tibersam/lightcontroller-schematic/lightcontroll-4.png

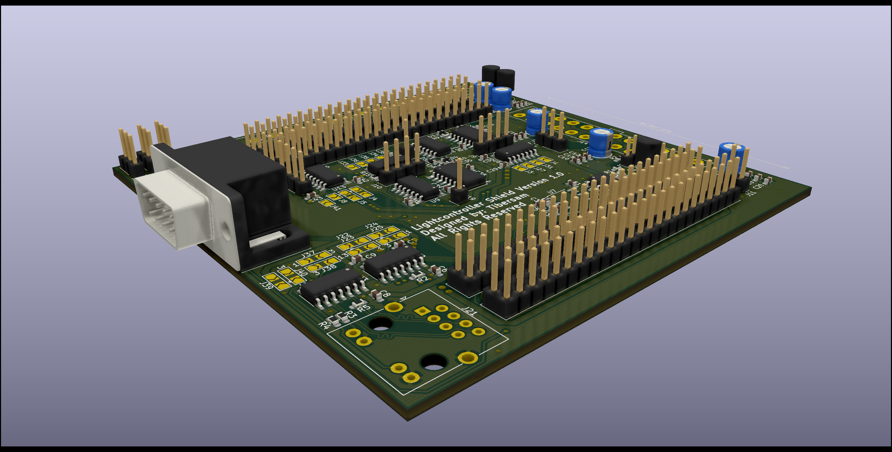
lightcontroll-4.png
