tibersam/lightcontroller-schematic/lightcontroll-6.jpg

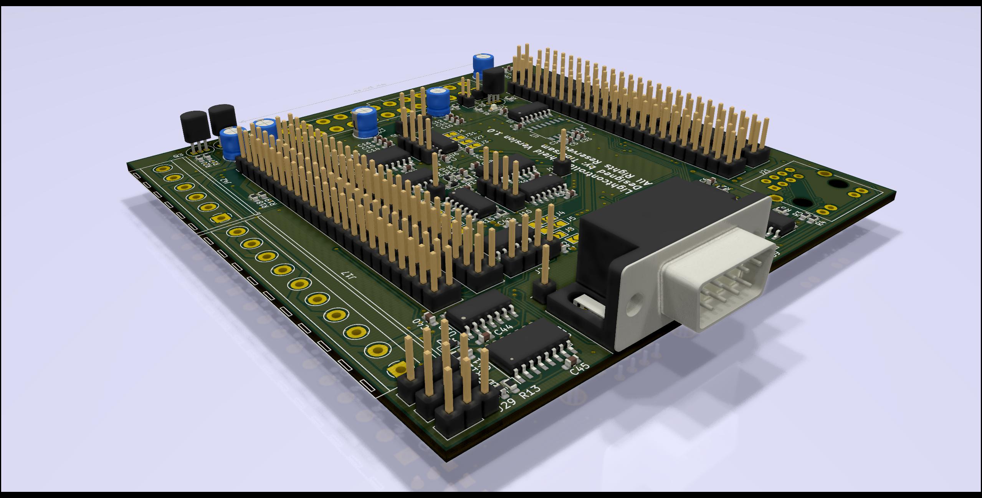
lightcontroll-6.jpg
