tibersam/lightcontroller-schematic/lightcontroll-2.png

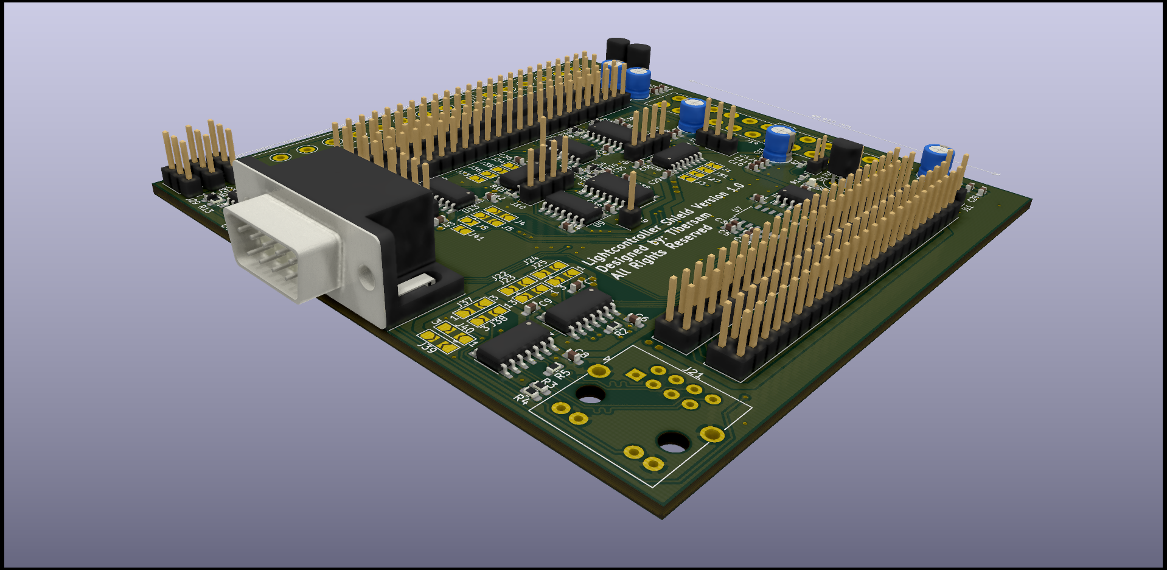
lightcontroll-2.png
