tibersam/lightcontroller-schematic/lightcontroll-3.png

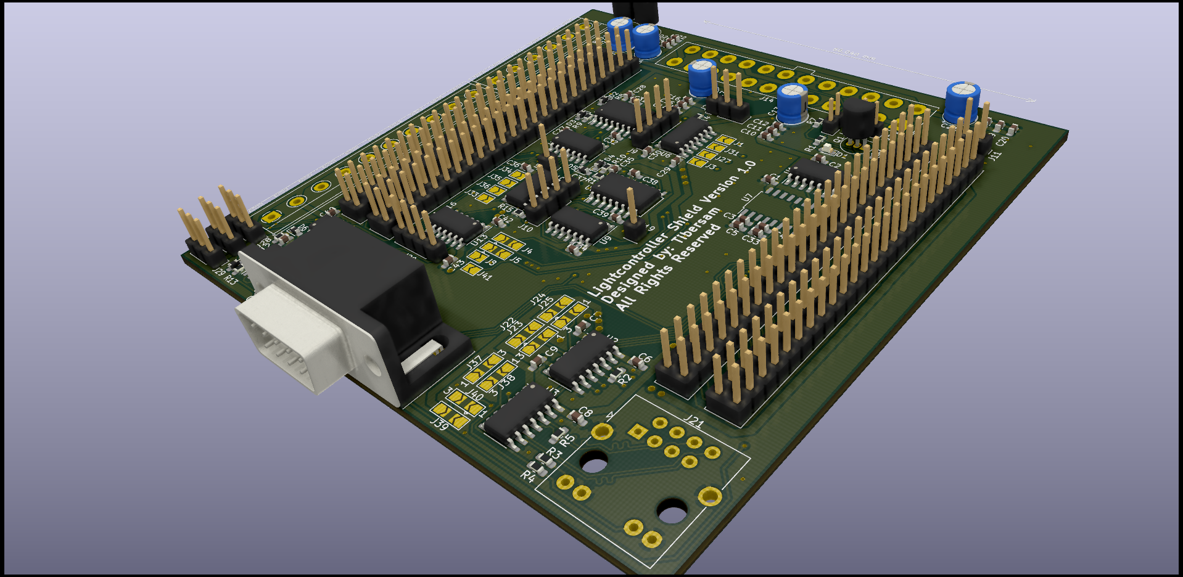
lightcontroll-3.png
