tibersam/lightcontroller-schematic/lightcontroll-5.jpg

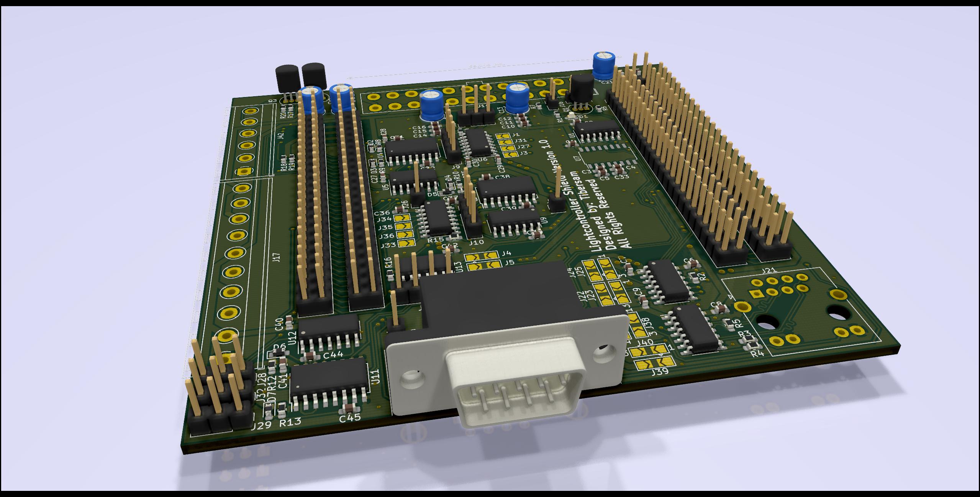
lightcontroll-5.jpg
