tibersam/lightcontroller-schematic/lightcontroll-5.png

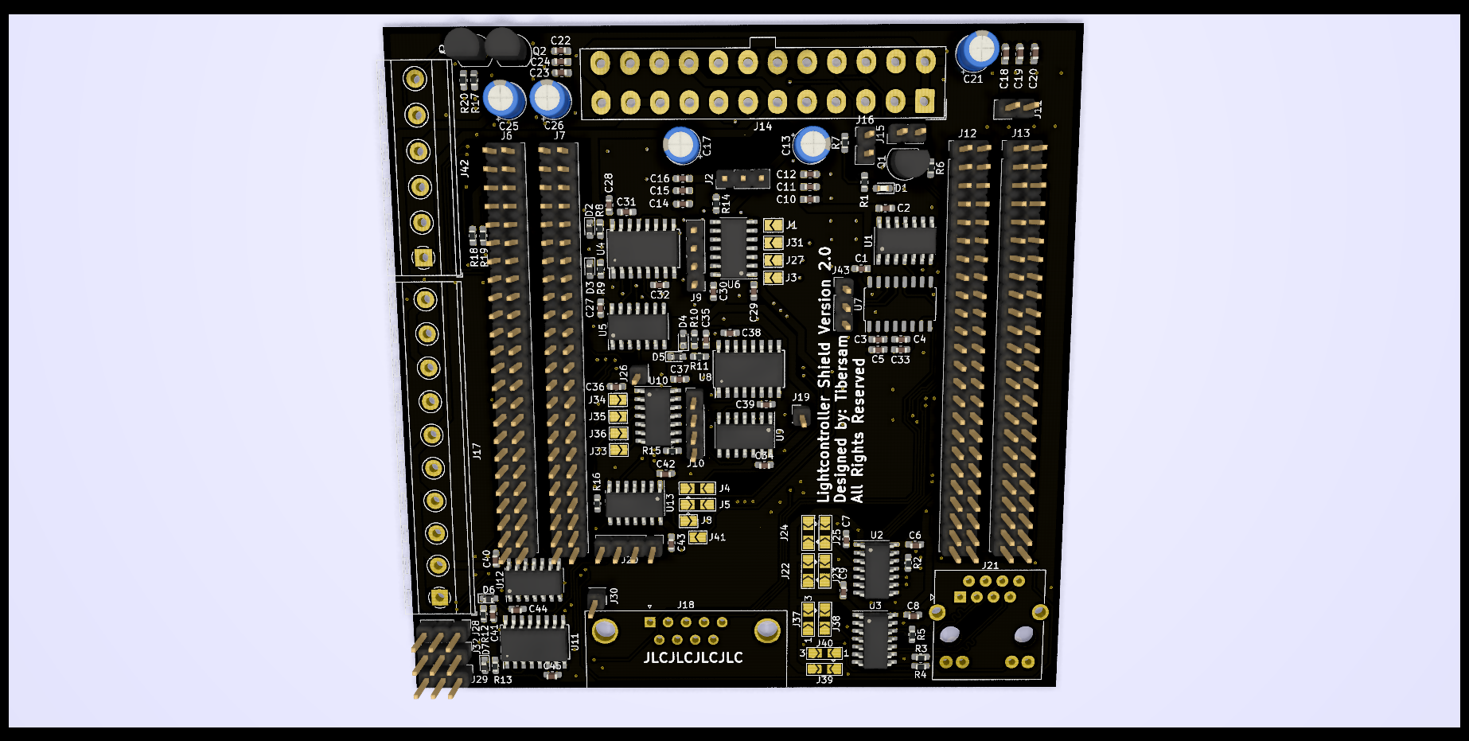
lightcontroll-5.png
