tibersam/lightcontroller-schematic/lightcontroll.png

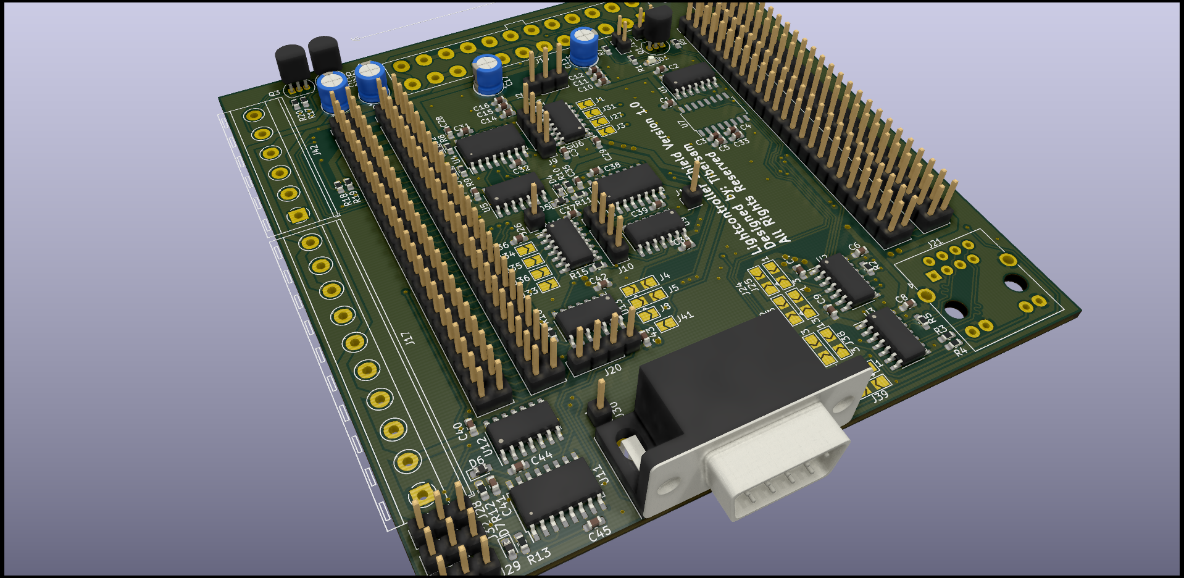
lightcontroll.png
