tibersam/lightcontroller-schematic/schematic/lightcontroll/lightcontroll.kicad_pcb

## KiCad design schematic/lightcontroll/lightcontroll.kicad_pcb (2022-01-22)

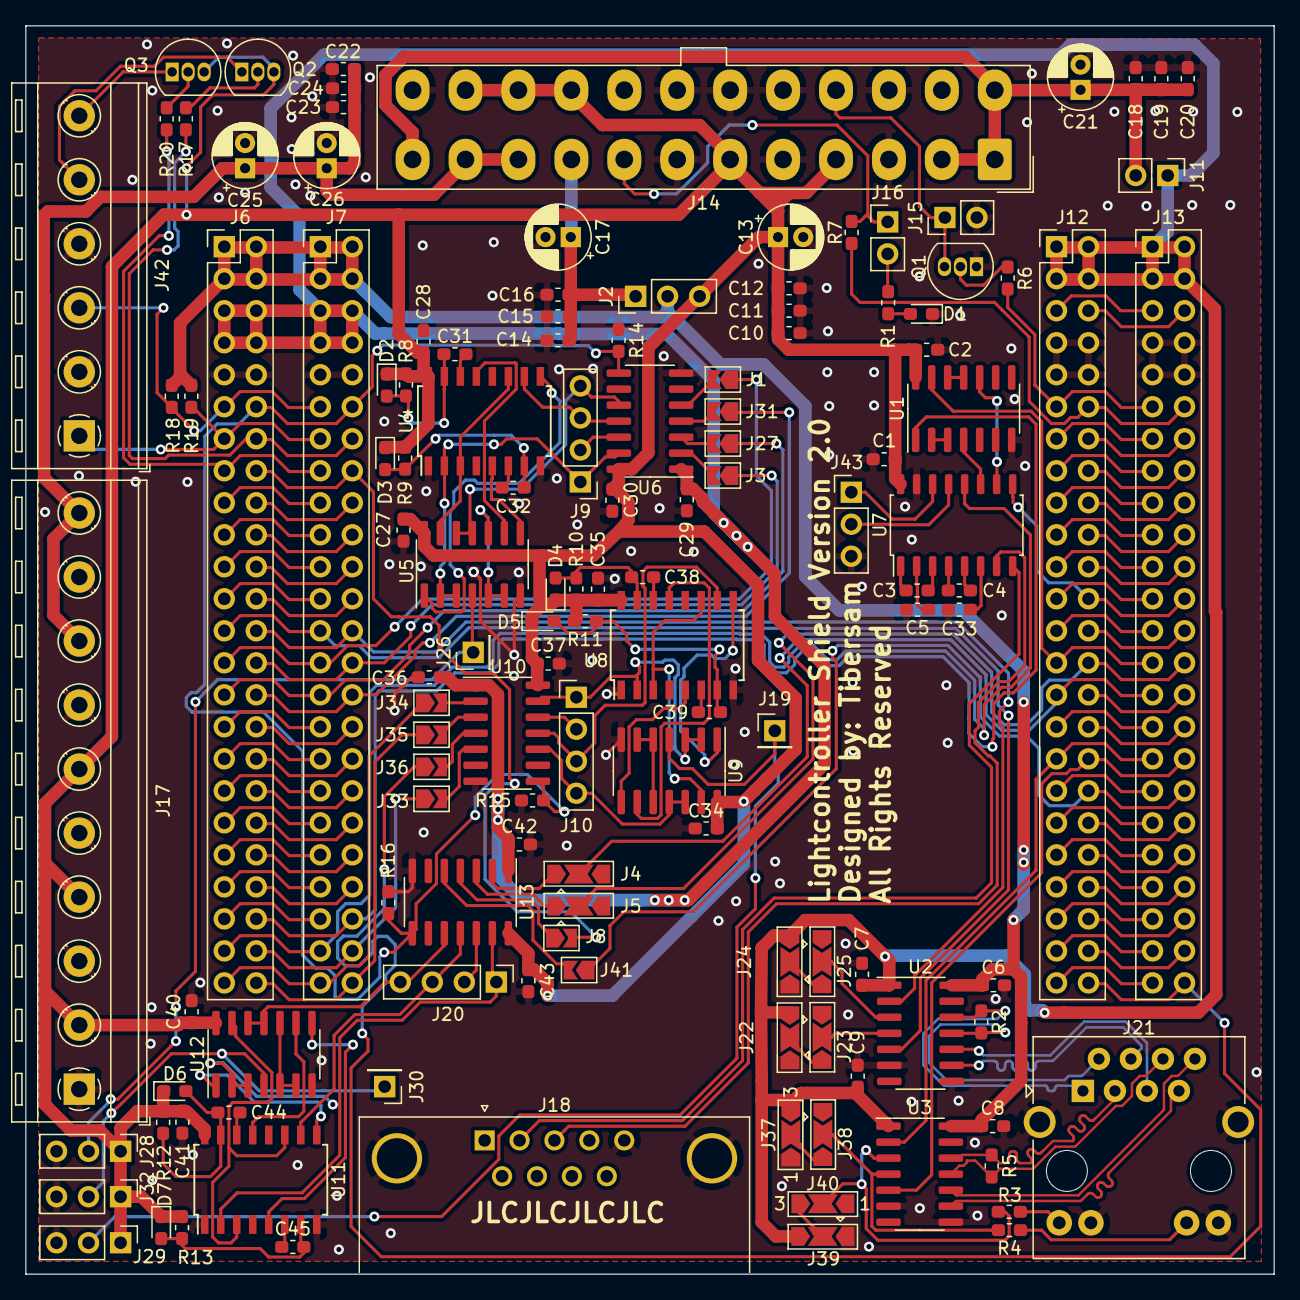
[picture p8: board lightcontroll.kicad_pcb from above]

Board: 2 copper layers, 99.1 x 99.1 mm, 131 parts (0 on the bottom side), 180 nets.

Parts:
C1, C3, C4, C5, C6, C8, C11, C15, C19, C23, C33: 1uF; C_0603_1608Metric_Pad1.05x0.95mm_HandSolder
C2, C7, C9, C10, C14, C18, C22, C27, C28, C29, C30, C34, C35, C36, C37, C40, C41, C42, C43: 100nF; C_0603_1608Metric_Pad1.05x0.95mm_HandSolder
C12, C16, C20, C24: 10uF; C_0603_1608Metric_Pad1.05x0.95mm_HandSolder
C13, C17, C21, C25, C26: 100uF; CP_Radial_D5.0mm_P2.00mm
C31, C32, C38, C39, C44, C45: 200pF; C_0603_1608Metric_Pad1.05x0.95mm_HandSolder
D1: LED; LED_0603_1608Metric_Pad1.05x0.95mm_HandSolder
D2, D3, D4, D5, D6, D7: D_Schottky; D_0603_1608Metric_Pad1.05x0.95mm_HandSolder
J1: SPI1_SS; SolderJumper-2_P1.3mm_Open_TrianglePad1.0x1.5mm
J2: 5V Selector; PinHeader_1x03_P2.54mm_Vertical
J3: SPI1_CLK; SolderJumper-2_P1.3mm_Open_TrianglePad1.0x1.5mm
J4, J5: UART/SPI JUMPER; SolderJumper-3_P2.0mm_Open_TrianglePad1.0x1.5mm
J6, J7: Conn_02x24_Odd_Even; PinHeader_2x24_P2.54mm_Vertical
J8: UART/SPI JUMPER; SolderJumper-2_P1.3mm_Open_TrianglePad1.0x1.5mm
J9, J10, J20: SPI 5V; PinHeader_1x04_P2.54mm_Vertical
J11: 3.3V jumper; PinHeader_1x02_P2.54mm_Vertical
J12, J13: Header 24X2; PinHeader_2x24_P2.54mm_Vertical
J14: ATX24connector; Molex_Mini-Fit_Jr_5566-24A_2x12_P4.20mm_Vertical
J15, J16: PWR_JMP; PinHeader_1x02_P2.54mm_Vertical
J17: Power Connector; TerminalBlock_RND_205-00295_1x10_P5.08mm_Horizontal
J18: DB9_Female_MountingHoles; DSUB-9_Male_Horizontal_P2.77x2.84mm_EdgePinOffset7.70mm_Hou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
J19, J26, J30: SK2812_sig; PinHeader_1x01_P2.54mm_Vertical
J21: RJ45_LED_Shielded; RJ45_BEL_SS74301-00x_Vertical
J22, J23, J24, J25, J38, J39: Conn_01x03; SolderJumper-3_P2.0mm_Open_TrianglePad1.0x1.5mm
J27: SPI1_MISO; SolderJumper-2_P1.3mm_Open_TrianglePad1.0x1.5mm
J28, J29, J32, J43: Conn_01x03; PinHeader_1x03_P2.54mm_Vertical
J31: SPI1_MOSI; SolderJumper-2_P1.3mm_Open_TrianglePad1.0x1.5mm
J33: SPI2_SS; SolderJumper-2_P1.3mm_Open_TrianglePad1.0x1.5mm
J34: SPI2_CLK; SolderJumper-2_P1.3mm_Open_TrianglePad1.0x1.5mm
J35: SPI2_MISO; SolderJumper-2_P1.3mm_Open_TrianglePad1.0x1.5mm
J36: SPI2_MOSI; SolderJumper-2_P1.3mm_Open_TrianglePad1.0x1.5mm
J37, J40: Conn_01x03; SolderJumper-3_P2.0mm_Open_TrianglePad1.0x1.5mm_NumberLabels
J41: Conn_01x02; SolderJumper-2_P1.3mm_Open_TrianglePad1.0x1.5mm
J42: Buttonconnector; TerminalBlock_RND_205-00291_1x06_P5.08mm_Horizontal
Q1: 2N7000; TO-92_Inline
Q2, Q3: 2N2222A; TO-92_Inline
R1, R3, R4: 200; R_0603_1608Metric_Pad1.05x0.95mm_HandSolder
R2, R5: 120; R_0603_1608Metric_Pad1.05x0.95mm_HandSolder
R6, R7: 10K; R_0603_1608Metric_Pad1.05x0.95mm_HandSolder
R8, R10, R12: 6.5k; R_0603_1608Metric_Pad1.05x0.95mm_HandSolder
R9, R11, R13: 3.3K; R_0603_1608Metric_Pad1.05x0.95mm_HandSolder
R14, R15, R16: 100k; R_0603_1608Metric_Pad1.05x0.95mm_HandSolder
R17, R20: 1K; R_0603_1608Metric_Pad1.05x0.95mm_HandSolder
R18, R19: 100K; R_0603_1608Metric_Pad1.05x0.95mm_HandSolder
U1: 74HC14; SOIC-14_3.9x8.7mm_P1.27mm
U2, U3: MAX13433EESD; SOIC-14_3.9x8.7mm_P1.27mm
U4, U8, U11: 74LS123; SOIC-16W_5.3x10.2mm_P1.27mm
U5, U9, U12: 7402; SOIC-14_3.9x8.7mm_P1.27mm
U6, U10, U13: TXB0104D; SOIC-14_3.9x8.7mm_P1.27mm
U7: MAX232; SOP-16_4.55x10.3mm_P1.27mm

Connections:
+3V3: C18.1, C19.1, C20.1, C21.1, J11.2, J14.1, J14.2, J14.12, J14.13
+5VD: C1.1, C2.1, C10.1, C11.1, C12.1, C13.1, C27.1, C28.1, C30.2, C34.1, C35.1, C37.2, C40.1, C41.1, C43.2, D2.1, D3.1, D4.1, D5.1, D6.1, D7.1, J2.3, J14.4, J14.6, J14.21, J14.22, J14.23, J17.2, J17.4, J17.6, J28.1, J29.1, J32.1, Q2.3, Q3.3, R8.1, R9.1, R10.1, R11.1, R12.1, R13.1, U1.14, U4.16, U5.14, U6.14, U7.16, U8.16, U9.14, U10.14, U11.16, U12.14, U13.14
+5VL: C14.1, C15.1, C16.1, C17.1, J2.1, J14.9
+12V: C22.1, C23.1, C24.1, C25.1, C26.1, J14.10, J14.11, J17.8, J17.10
/3V3_MC: C7.1, C9.1, C29.1, C36.1, C42.1, J6.5, J6.6, J6.7, J6.8, J7.5, J7.6, J7.7, J7.8, J11.1, J12.1, J12.2, J12.3, J12.4, J13.1, J13.2, J13.3, J13.4, J22.3, J24.3, J37.3, J39.3, U2.1, U3.1, U6.1, U10.1, U13.1
/5V_UART: C6.1, C8.1, J2.2, J6.1, J6.2, J6.3, J6.4, J7.1, J7.2, J7.3, J7.4, R18.2, R19.1, U2.14, U3.14
/ATX_Power/PS_ON: J14.16, J15.1, Q1.3
/ATX_Power/PWR_OK_INT: J14.8, J16.1, R7.2
/En_Level_SPI: J6.12, J7.12, R14.2, R15.2, R16.2, U6.8, U10.8, U13.8
/PE2: J6.11, J7.11, J42.3, R19.2
/PE4: J6.13, J7.13, J42.1, R18.1
/PE5: J6.14, J7.14, R17.2
/PE6: J6.15, J7.15, R20.2
/PS_ON: J12.11, J13.11, R6.2
/PWR_OK: J12.12, J13.12, R7.1
/SPI1_CLK: J3.2, U6.2
/SPI1_MISO: J27.2, U6.3
/SPI1_MOSI: J31.2, U6.4
/SPI1_SS: J1.2, U6.5
/SPI2_CLK: J34.2, U10.2
/SPI2_MISO: J35.2, U10.3
/SPI2_MOSI: J36.2, U10.4
/SPI2_SS: J33.2, U10.5
/SPI3_CLK: J4.1, U13.2
/SPI3_MISO: J5.1, U13.3
/SPI3_MOSI: J8.1, U13.4
/SPI3_SS: J41.2, U13.5
/SPI_WS2812_DRIVERS/CLK5V: J9.1, U4.2, U5.2, U5.3, U6.13
/SPI_WS2812_DRIVERS/CLR: U4.3, U4.11, U5.13
/SPI_WS2812_DRIVERS/CS0_5V: J9.4, U5.11, U5.12, U6.10
/SPI_WS2812_DRIVERS/MOSI5V: J9.3, U4.10, U6.11
/SPI_WS2812_DRIVERS/ONE: U4.5, U5.8
/SPI_WS2812_DRIVERS/SK2812_sig: J26.1, J28.2, U5.4
/SPI_WS2812_DRIVERS/Zero: U4.13, U5.9
/UART1_RX: J12.33, J13.33, U3.2
/UART1_TX: J12.34, J13.34, U3.5
/UART2_RX: J6.26, J7.26, U2.2
/UART2_TX: J6.25, J7.25, U2.5
/UART3_RX: J6.45, J7.45, U7.12
/UART3_TX: J6.44, J7.44, U1.1
/UART5_RX: J12.24, J13.24, U7.9
/UART5_TX: J12.27, J13.27, U1.13
/UART6_RX: J12.38, J13.38
/UART6_TX: J12.39, J13.39
/UART Connections/UARTA_RX_EN_JMP: J38.2, R4.1, U3.4
/UART Connections/UARTA_RX_N: J21.6, R5.2, U3.11
/UART Connections/UARTA_RX_P: J21.3, R5.1, U3.12
/UART Connections/UARTA_RX_Voltage: J37.2, J38.3
/UART Connections/UARTA_TX_EN_JMP: J40.2, R3.1, U3.3
/UART Connections/UARTA_TX_N: J21.8, U3.10
/UART Connections/UARTA_TX_P: J21.7, U3.9
/UART Connections/UARTA_TX_Voltage: J39.2, J40.3
/UART Connections/UARTB_RX_EN_JMP: J23.2, U2.4
/UART Connections/UARTB_RX_Voltage: J22.2, J23.3
/UART Connections/UARTB_TX_EN_JMP: J25.2, U2.3
/UART Connections/UARTB_TX_Voltage: J24.2, J25.3
/UART Connections/uartb_rx+: J21.1, R2.1, U2.12
/UART Connections/uartb_rx-: J21.2, R2.2, U2.11
/UART Connections/uartb_tx+: J21.4, U2.9
/UART Connections/uartb_tx-: J21.5, U2.10
/UART_RS232/UARTA_RS232_TX: U1.4, U7.11
/UART_RS232/UARTB_RS232_TX: U1.10, U7.10
/UART_RS232/USARTARX: J43.2, U7.13
/UART_RS232/USARTATX: J43.1, U7.14
/sheet5EBD8EE4/CLK5V: J10.1, U8.2, U9.2, U9.3, U10.13
/sheet5EBD8EE4/CLR: U8.3, U8.11, U9.13
/sheet5EBD8EE4/CS0_5V: J10.4, U9.11, U9.12, U10.10
/sheet5EBD8EE4/MOSI5V: J10.3, U8.10, U10.11
/sheet5EBD8EE4/ONE: U8.5, U9.8
/sheet5EBD8EE4/SK2812_sig: J19.1, J29.2, U9.4
/sheet5EBD8EE4/Zero: U8.13, U9.9
/sheet5EBDAB70/CLK5V: J20.1, U11.2, U12.2, U12.3, U13.13
/sheet5EBDAB70/CLR: U11.3, U11.11, U12.13
/sheet5EBDAB70/CS0_5V: J20.4, U12.11, U12.12, U13.10
/sheet5EBDAB70/MOSI5V: J20.3, U11.10, U13.11
/sheet5EBDAB70/ONE: U11.5, U12.8
/sheet5EBDAB70/SK2812_sig: J30.1, J32.2, U12.4
/sheet5EBDAB70/Zero: U11.13, U12.9
/stm32f407_blackboard/BOOT1: J12.6, J13.6
/stm32f407_blackboard/Boot0: J12.5, J13.5
/stm32f407_blackboard/PA0,WK_UP: J6.23, J7.23
/stm32f407_blackboard/PA1: J6.24, J7.24
/stm32f407_blackboard/PA4: J1.1, J6.27, J7.27
/stm32f407_blackboard/PA5: J3.1, J6.28, J7.28
/stm32f407_blackboard/PA6: J6.29, J7.29, J27.1
/stm32f407_blackboard/PA7: J6.30, J7.30, J31.1
/stm32f407_blackboard/PA8: J12.35, J13.35
/stm32f407_blackboard/PA11_USB_DM: J12.32, J13.32
/stm32f407_blackboard/PA12USB_DP: J12.31, J13.31
/stm32f407_blackboard/PA15_TD1SWD: J12.30, J13.30
/stm32f407_blackboard/PB0: J6.33, J7.33
/stm32f407_blackboard/PB1: J6.34, J7.34
/stm32f407_blackboard/PB3_TD0_SWD: J12.18, J13.18
/stm32f407_blackboard/PB5: J12.17, J13.17
/stm32f407_blackboard/PB6: J12.16, J13.16
/stm32f407_blackboard/PB7: J12.15, J13.15
/stm32f407_blackboard/PB8: J12.14, J13.14
/stm32f407_blackboard/PB9: J12.13, J13.13
/stm32f407_blackboard/PB12: J6.46, J7.46, J33.1
/stm32f407_blackboard/PB13: J6.47, J7.47, J34.1
/stm32f407_blackboard/PB14: J6.48, J7.48, J35.1
/stm32f407_blackboard/PB15: J12.48, J13.48, J36.1
/stm32f407_blackboard/PC0: J6.17, J7.17
/stm32f407_blackboard/PC1: J6.18, J7.18
/stm32f407_blackboard/PC2: J6.19, J7.19
/stm32f407_blackboard/PC3: J6.20, J7.20
/stm32f407_blackboard/PC4: J6.31, J7.31
/stm32f407_blackboard/PC5: J6.32, J7.32
/stm32f407_blackboard/PC8: J12.37, J13.37
/stm32f407_blackboard/PC9: J12.36, J13.36, J41.1
/stm32f407_blackboard/PC10: J4.2, J12.29, J13.29
/stm32f407_blackboard/PC11: J5.2, J12.28, J13.28
/stm32f407_blackboard/PC13: J6.16, J7.16, J8.2
/stm32f407_blackboard/PD0: J12.26, J13.26
/stm32f407_blackboard/PD1: J12.25, J13.25
/stm32f407_blackboard/PD3: J12.23, J13.23
/stm32f407_blackboard/PD4: J12.22, J13.22
/stm32f407_blackboard/PD5: J12.21, J13.21
/stm32f407_blackboard/PD6: J12.20, J13.20
/stm32f407_blackboard/PD7: J12.19, J13.19
/stm32f407_blackboard/PD8: J12.47, J13.47
/stm32f407_blackboard/PD9: J12.46, J13.46
/stm32f407_blackboard/PD10: J12.45, J13.45
/stm32f407_blackboard/PD11: J12.44, J13.44
/stm32f407_blackboard/PD12: J12.43, J13.43
/stm32f407_blackboard/PD13: J12.42, J13.42
/stm32f407_blackboard/PD14: J12.41, J13.41
/stm32f407_blackboard/PD15: J12.40, J13.40
/stm32f407_blackboard/PE7: J6.35, J7.35
/stm32f407_blackboard/PE8: J6.36, J7.36
/stm32f407_blackboard/PE9: J6.37, J7.37
/stm32f407_blackboard/PE10: J6.38, J7.38
/stm32f407_blackboard/PE11: J6.39, J7.39
/stm32f407_blackboard/PE12: J6.40, J7.40
/stm32f407_blackboard/PE13: J6.41, J7.41
/stm32f407_blackboard/PE14: J6.42, J7.42
/stm32f407_blackboard/PE15: J6.43, J7.43
/stm32f407_blackboard/VREF+: J6.22, J7.22
/stm32f407_blackboard/VREF-: J6.21, J7.21
GNDREF: C1.2, C2.2, C5.2, C6.2, C7.2, C8.2, C9.2, C10.2, C11.2, C12.2, C13.2, C14.2, C15.2, C16.2, C17.2, C18.2, C19.2, C20.2, C21.2, C22.2, C23.2, C24.2, C25.2, C26.2, C27.2, C28.2, C29.2, C30.1, C33.1, C34.2, C35.2, C36.2, C37.1, C40.2, C41.2, C42.2, C43.1, D1.1, J6.9, J6.10, J7.9, J7.10, J12.7, J12.8, J12.9, J12.10, J13.7, J13.8, J13.9, J13.10, J14.3, J14.5, J14.7, J14.15, J14.17, J14.18, J14.19, J14.24, J15.2, J17.1, J17.3, J17.5, J17.7, J17.9, J18.0, J18.5, J21.9, J21.11, J21.SH, J22.1, J24.1, J28.3, J29.3, J32.3, J37.1, J39.1, J42.2, J42.4, J43.3, Q1.1, R14.1, R15.1, R16.1, U1.7, U2.6, U2.8, U3.6, U3.8, U4.1, U4.8, U5.7, U6.7, U7.15, U8.1, U8.8, U9.7, U10.7, U11.1, U11.8, U12.7, U13.7
unnamed: C3.1, U7.1
unnamed: C3.2, U7.3
unnamed: C4.1, U7.4
unnamed: C4.2, U7.5
unnamed: C5.1, U7.2
unnamed: C31.1, D2.2, R8.2, U4.15
unnamed: C31.2, U4.14
unnamed: C32.1, U4.6
unnamed: C32.2, D3.2, R9.2, U4.7
unnamed: C33.2, U7.6
unnamed: C38.1, D4.2, R10.2, U8.15
unnamed: C38.2, U8.14
unnamed: C39.1, U8.6
unnamed: C39.2, D5.2, R11.2, U8.7
unnamed: C44.1, D6.2, R12.2, U11.15
unnamed: C44.2, U11.14
unnamed: C45.1, U11.6
unnamed: C45.2, D7.2, R13.2, U11.7
unnamed: D1.2, R1.2
unnamed: J9.2, U6.12
unnamed: J10.2, U10.12
unnamed: J16.2, R1.1
unnamed: J18.2, U7.8
unnamed: J18.3, U7.7
unnamed: J20.2, U13.12
unnamed: J21.10, R4.2
unnamed: J21.12, R3.2
unnamed: J42.5, Q2.1
unnamed: J42.6, Q3.1
unnamed: Q1.2, R6.1
unnamed: Q2.2, R17.1
unnamed: Q3.2, R20.1
unnamed: U1.2, U1.3
unnamed: U1.11, U1.12
unnamed: U4.9, U5.1
unnamed: U5.5, U5.6, U5.10
unnamed: U8.9, U9.1
unnamed: U9.5, U9.6, U9.10
unnamed: U11.9, U12.1
unnamed: U12.5, U12.6, U12.10
