tibersam/lightcontroller-schematic/(commit log)

2019-03-19 save before potential crash
    [Power_management.sch, lightcontroll.sch, stm32f407blackboard.sch, uart_connections.sch]
2019-03-23 build backup
    [Power_management.sch, lightcontroll.sch, stm32f407blackboard.sch, uart_connections.sch]
2019-04-03 save state
    [Power_management.sch, lightcontroll.sch, stm32f407blackboard.sch, uart_connections.sch]
2020-05-26 Update backup of circuit
    [IR-Recieve.sch, SPI_WS2812_DRIVERS.sch, UART_RS232.sch, lightcontroll.csv, spi_neopixel_rev2.sch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]
2020-09-10 save Version 1.0
    [IR-Recieve.sch, Power_management.sch, SPI_WS2812_DRIVERS.sch, UART_RS232.sch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]
2021-04-10 save current state of project. Added gitignore for kicad
2022-01-22 Updated PCB to Revision 2.0
    - Added an 2.54mm pin header for second RS232 UART, which was already available in rev 1.0
    - Changed all 2.00mm pin header to 2.54mm pin header. This fixes the mistake done in selecting the wrong footprint in rev 1.0
    - Corrected schematic and layout of the spi to sk2812 circuits. During testing of previous rev some mistakes where found.
    * the second logical schemitac part of 74ls123 changes meaning of pin 6 and 7 compared to 15 and 14 of the first
    * The vibrator for the one signal needs to be also triggered with every rising edge, so use input A instead of binding it to gnd
    * Use the fourth nand to invert clock signal for a input of one vibrator
    [IR-Recieve.sch, Power_management.sch, SPI_WS2812_DRIVERS.sch, UART_RS232.sch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]
