tibersam/lightcontroller-schematic/(notices)

Notices in the files:
schematic/lightcontroll/lightcontroll.kicad_pcb:
All Rights Reserved
